Recscue/LG-ultrafine-5k-sun-shades/renders/03-spine.png

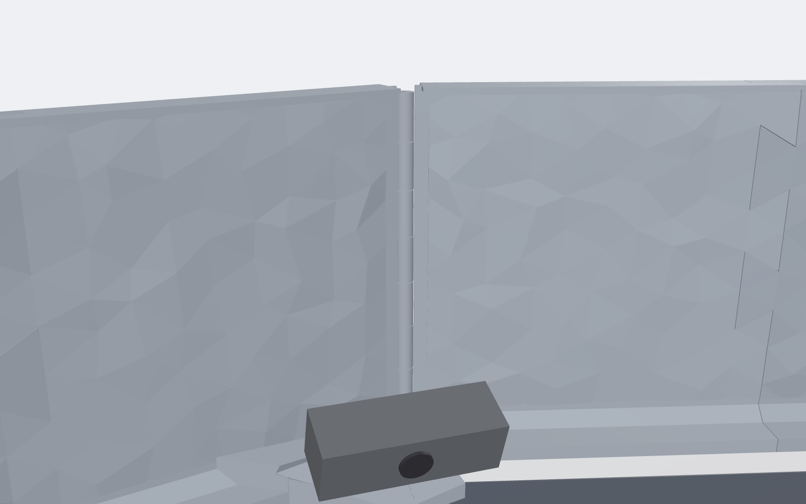
renders/03-spine.png
