Recscue/LG-ultrafine-5k-sun-shades/renders/04-seam-front.png

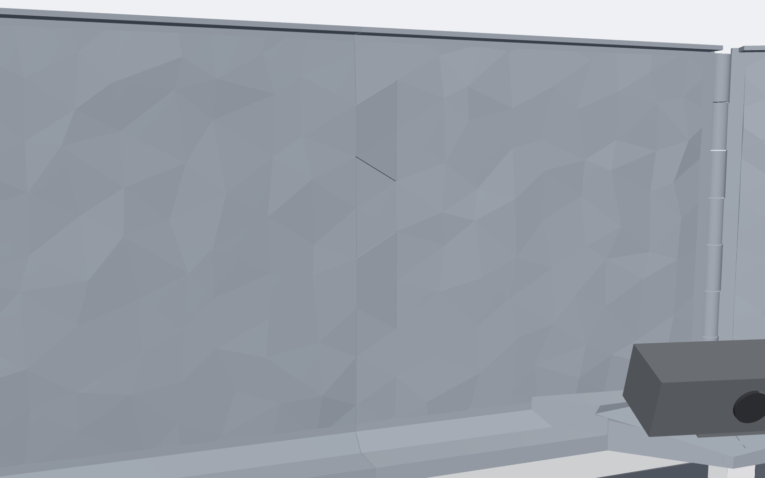
renders/04-seam-front.png
