Recscue/LG-ultrafine-5k-sun-shades/renders/06-exploded.png

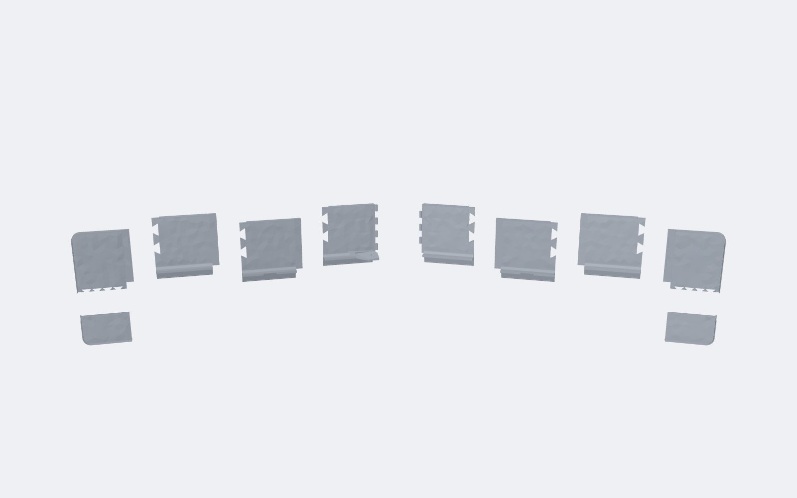
renders/06-exploded.png
