Recscue/LG-ultrafine-5k-sun-shades/renders/08-corner.png

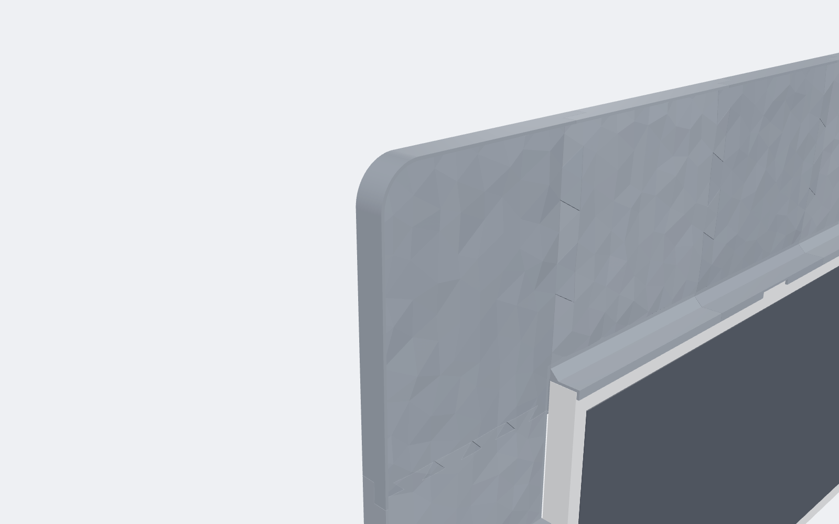
renders/08-corner.png
