Recscue/LG-ultrafine-5k-sun-shades/renders/12-shelf-underside.png

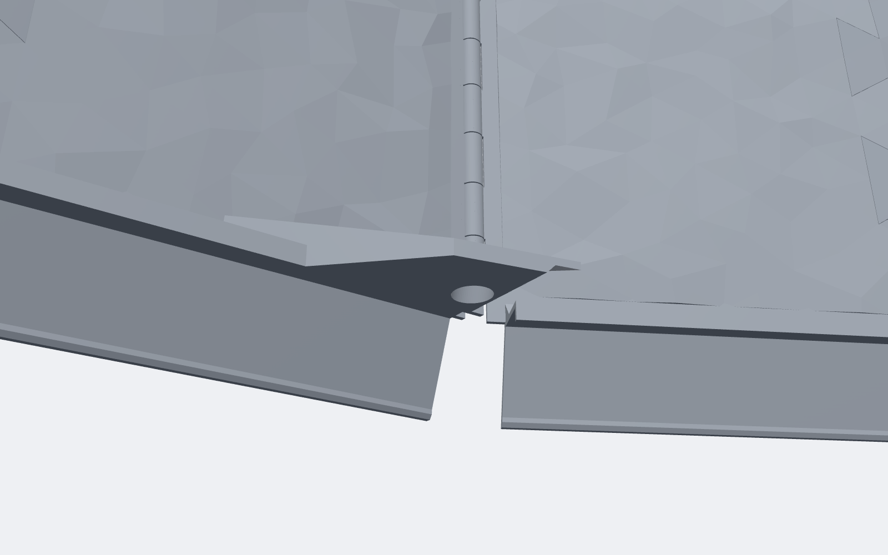
renders/12-shelf-underside.png
