Recscue/LG-ultrafine-5k-sun-shades/renders/13-side-back.png

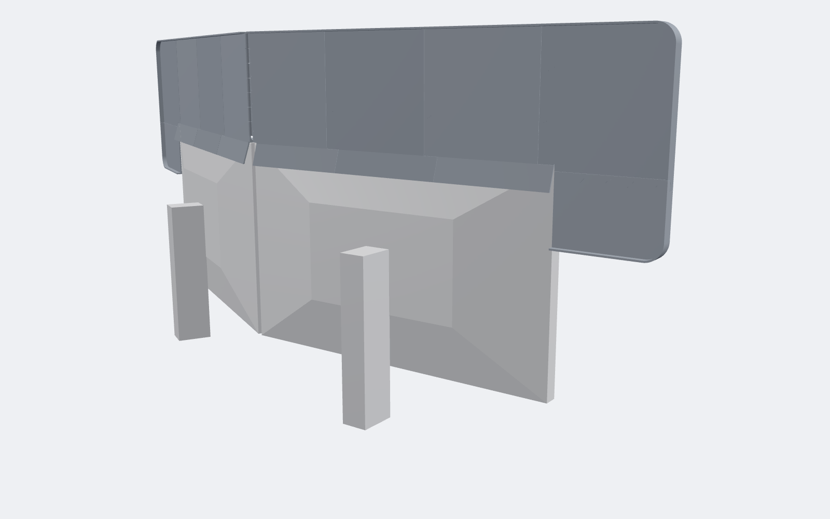
renders/13-side-back.png
