Recscue/LG-ultrafine-5k-sun-shades/renders/14-plateA.png

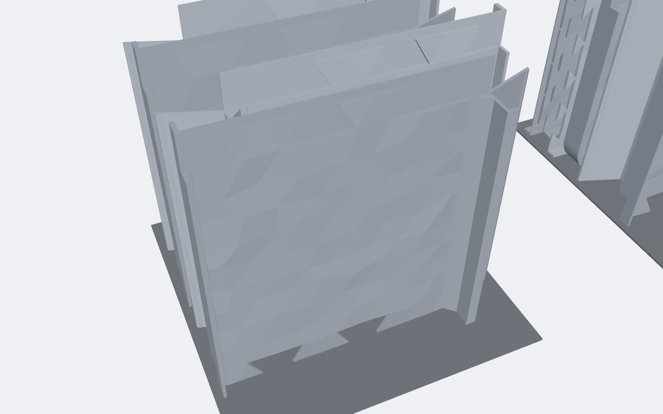
renders/14-plateA.png
