Recscue/LG-ultrafine-5k-sun-shades/renders/14-plateB.png

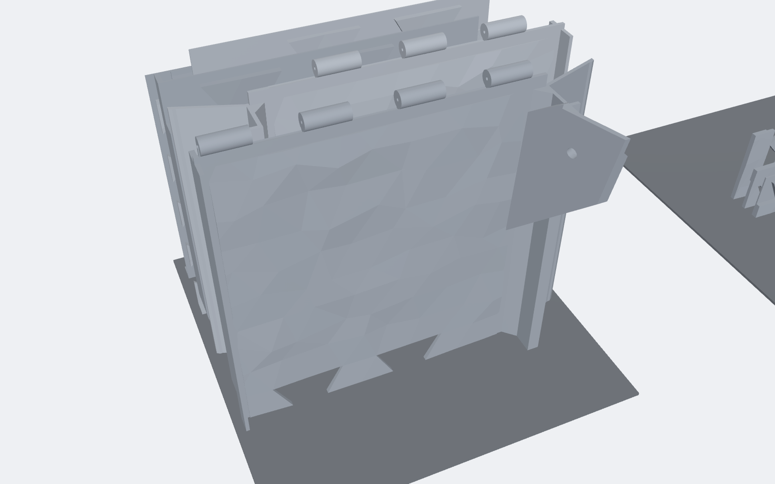
renders/14-plateB.png
