Recscue/LG-ultrafine-5k-sun-shades/renders/14-plateT.png

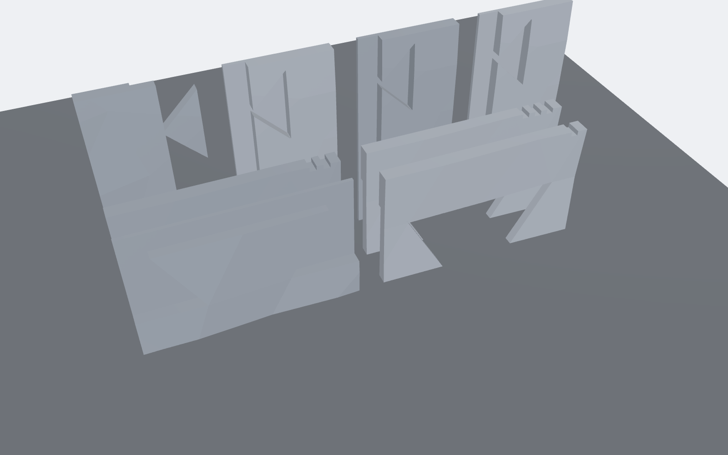
renders/14-plateT.png
