Recscue/LG-ultrafine-5k-sun-shades/print-files/step-1_test-prints/fit_seam_0.10mm_1-notch.stl

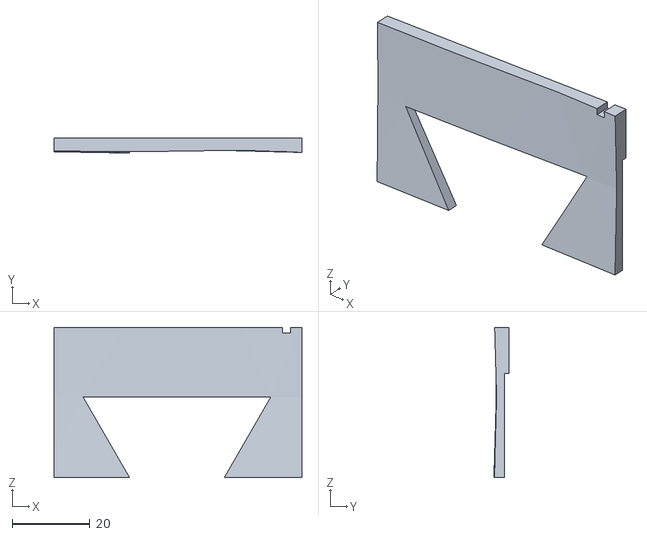
[picture p12: CAD file, 2026-11-04]
print-files/step-1_test-prints/fit_seam_0.10mm_1-notch.stl
64.0 x 3.93 x 38.8
