Recscue/LG-ultrafine-5k-sun-shades/print-files/step-2_full-shield/0.10mm_1-notch/left-monitor/left_4_inner_spine.stl

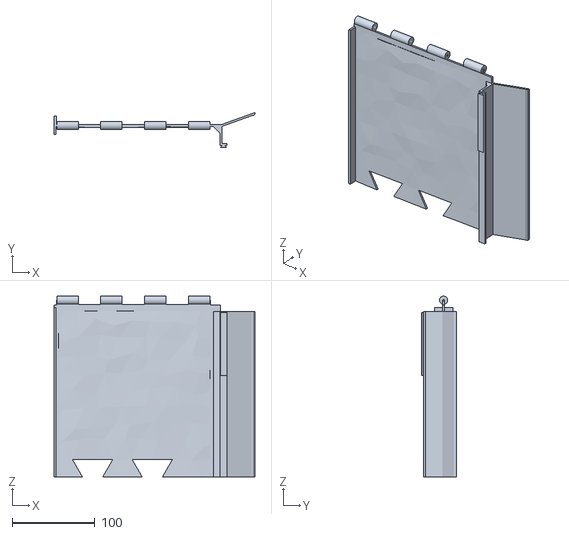
[picture p13: CAD file, 2026-11-04]
print-files/step-2_full-shield/0.10mm_1-notch/left-monitor/left_4_inner_spine.stl
243.2 x 42.3 x 218.8
