Recscue/LG-ultrafine-5k-sun-shades/print-files/step-2_full-shield/0.10mm_1-notch/right-monitor/right_2_outer.stl

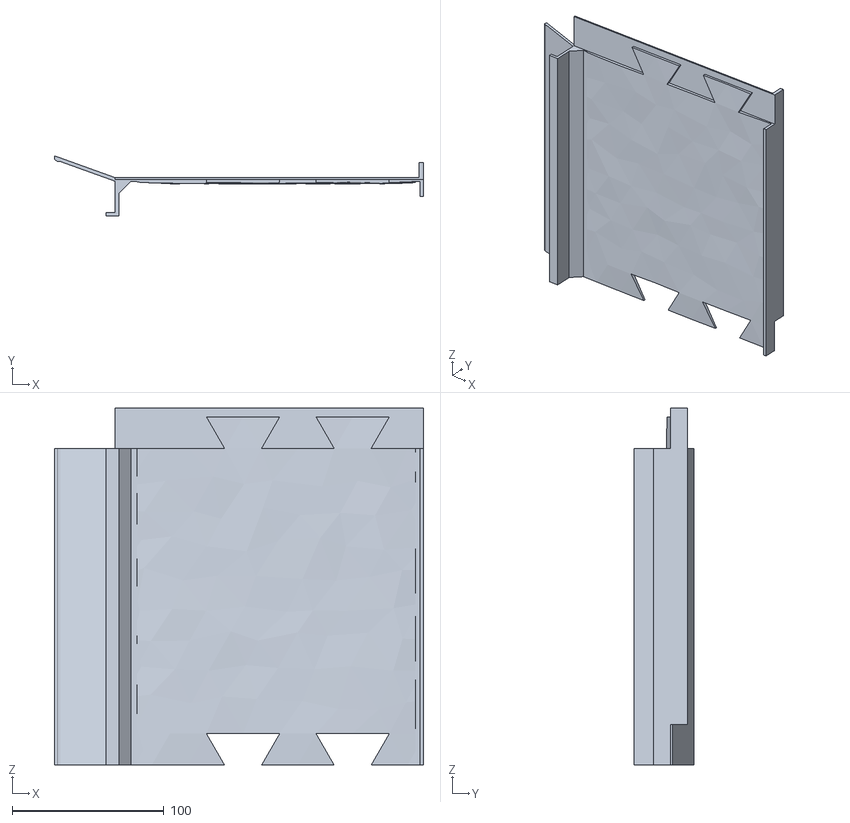
[picture p14: CAD file, 2026-11-04]
print-files/step-2_full-shield/0.10mm_1-notch/right-monitor/right_2_outer.stl
243.2 x 39.8 x 235.3
