Recscue/LG-ultrafine-5k-sun-shades/print-files/step-2_full-shield/0.15mm_2-notch/right-monitor/right_4_inner_spine.stl

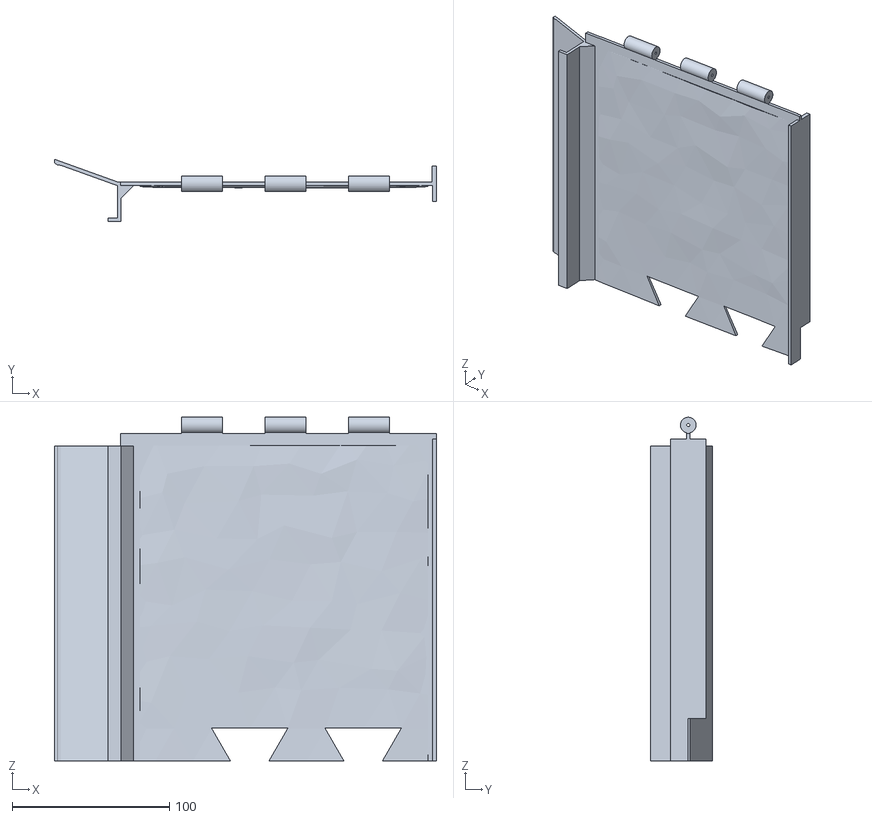
[picture p15: CAD file, 2026-11-04]
print-files/step-2_full-shield/0.15mm_2-notch/right-monitor/right_4_inner_spine.stl
243.2 x 39.8 x 218.7
