Recscue/LG-ultrafine-5k-sun-shades/print-files/step-2_full-shield/0.20mm_3-notch/left-monitor/left_2_outer.stl

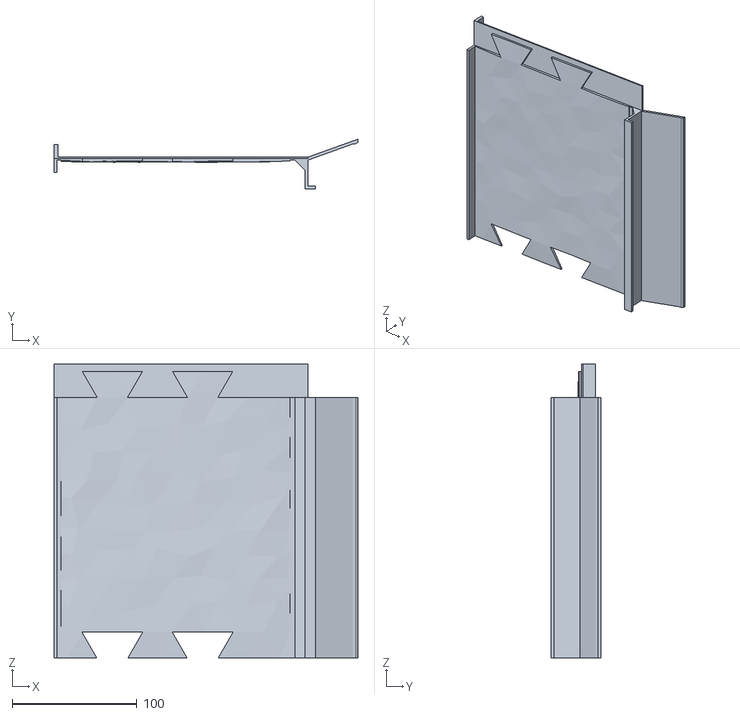
[picture p16: CAD file, 2026-11-04]
print-files/step-2_full-shield/0.20mm_3-notch/left-monitor/left_2_outer.stl
243.2 x 39.8 x 235.2
