Recscue/LG-ultrafine-5k-sun-shades/print-files/step-2_full-shield/0.20mm_3-notch/left-monitor/left_1_side-extension.stl

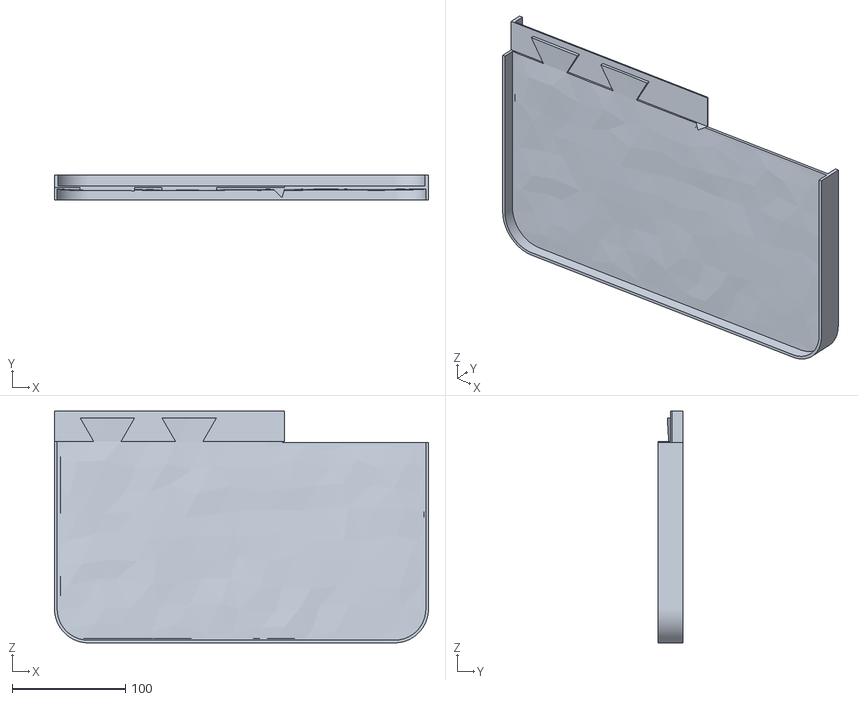
[picture p17: CAD file, 2026-11-04]
print-files/step-2_full-shield/0.20mm_3-notch/left-monitor/left_1_side-extension.stl
330.2 x 22.4 x 204.7
