Recscue/LG-ultrafine-5k-sun-shades/print-files/step-1_test-prints/fixed_seam.stl

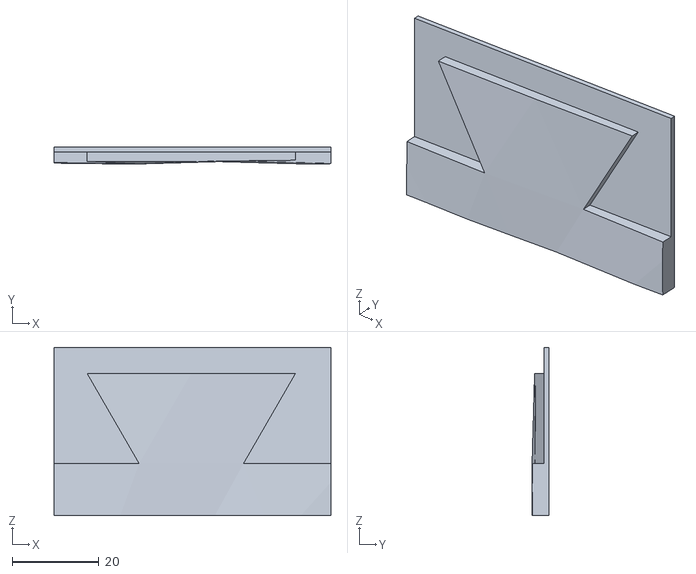
[picture p18: CAD file, 2026-11-04]
print-files/step-1_test-prints/fixed_seam.stl
64.0 x 3.96 x 38.9
