Recscue/LG-ultrafine-5k-sun-shades/print-files/step-2_full-shield/0.10mm_1-notch/left-monitor/left_5_webcam-shelf.stl

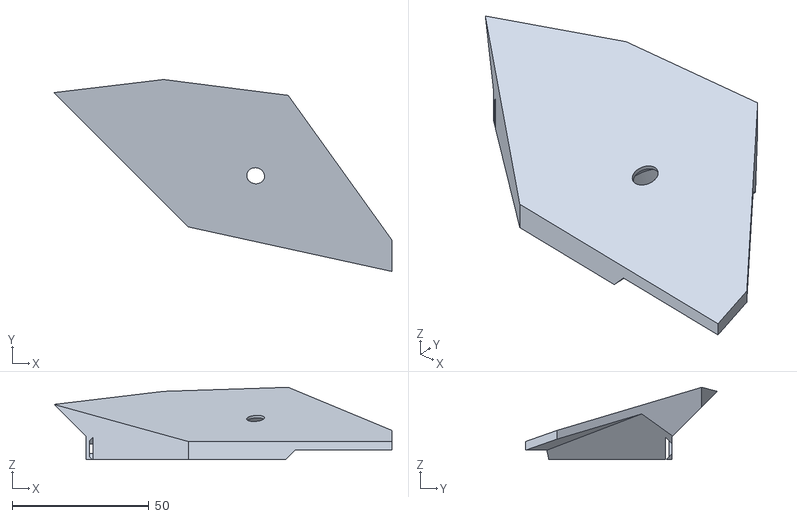
[picture p19: CAD file, 2026-11-04]
print-files/step-2_full-shield/0.10mm_1-notch/left-monitor/left_5_webcam-shelf.stl
123.7 x 70.2 x 26.5
