Recscue/LG-ultrafine-5k-sun-shades/(list of files, cad)

Other CAD files:
print-files/step-2_full-shield/0.15mm_2-notch/left-monitor/left_4_inner_spine.stl
print-files/step-2_full-shield/0.20mm_3-notch/right-monitor/right_2_outer.stl
print-files/step-1_test-prints/fit_seam_0.20mm_3-notch.stl
print-files/step-2_full-shield/0.10mm_1-notch/left-monitor/left_3_middle_monitor-camera-notch.stl
print-files/step-2_full-shield/0.10mm_1-notch/right-monitor/right_3_middle_monitor-camera-notch.stl
print-files/step-2_full-shield/0.15mm_2-notch/left-monitor/left_3_middle_monitor-camera-notch.stl
print-files/step-2_full-shield/0.15mm_2-notch/right-monitor/right_2_outer.stl
print-files/step-2_full-shield/0.20mm_3-notch/right-monitor/right_1_side-extension.stl
print-files/step-2_full-shield/0.10mm_1-notch/left-monitor/left_2_outer.stl
print-files/step-2_full-shield/0.10mm_1-notch/right-monitor/right_1_side-extension.stl
print-files/step-2_full-shield/0.15mm_2-notch/left-monitor/left_1_side-extension.stl
print-files/step-2_full-shield/0.15mm_2-notch/right-monitor/right_1_side-extension.stl
print-files/step-2_full-shield/0.20mm_3-notch/left-monitor/left_3_middle_monitor-camera-notch.stl
print-files/step-2_full-shield/0.20mm_3-notch/right-monitor/right_3_middle_monitor-camera-notch.stl
print-files/step-1_test-prints/fit_seam_0.15mm_2-notch.stl
print-files/step-2_full-shield/0.10mm_1-notch/left-monitor/left_1_side-extension.stl
print-files/step-2_full-shield/0.10mm_1-notch/right-monitor/right_4_inner_spine.stl
print-files/step-2_full-shield/0.15mm_2-notch/left-monitor/left_2_outer.stl
print-files/step-2_full-shield/0.15mm_2-notch/right-monitor/right_3_middle_monitor-camera-notch.stl
print-files/step-2_full-shield/0.20mm_3-notch/left-monitor/left_4_inner_spine.stl
print-files/step-2_full-shield/0.20mm_3-notch/right-monitor/right_4_inner_spine.stl
print-files/step-2_full-shield/0.15mm_2-notch/left-monitor/left_5_webcam-shelf.stl
print-files/step-2_full-shield/0.20mm_3-notch/left-monitor/left_5_webcam-shelf.stl
