Recscue/LG-ultrafine-5k-sun-shades/renders/print-plateB.png

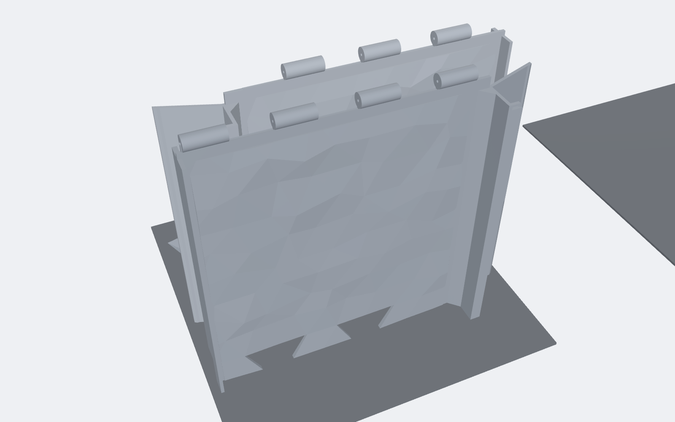
renders/print-plateB.png
