Recscue/LG-ultrafine-5k-sun-shades/renders/print-plateC.png

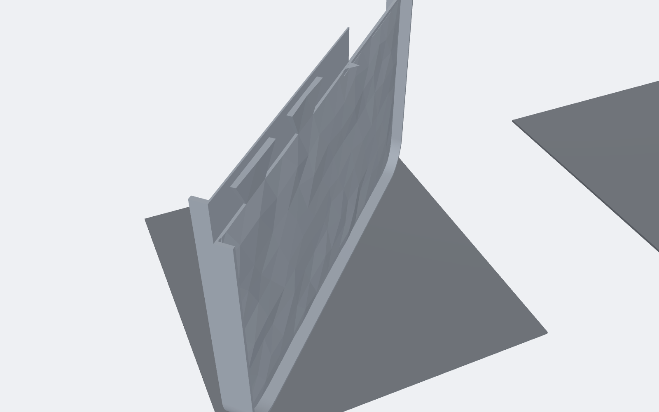
renders/print-plateC.png
