Recscue/LG-ultrafine-5k-sun-shades/renders/print-plateT.png

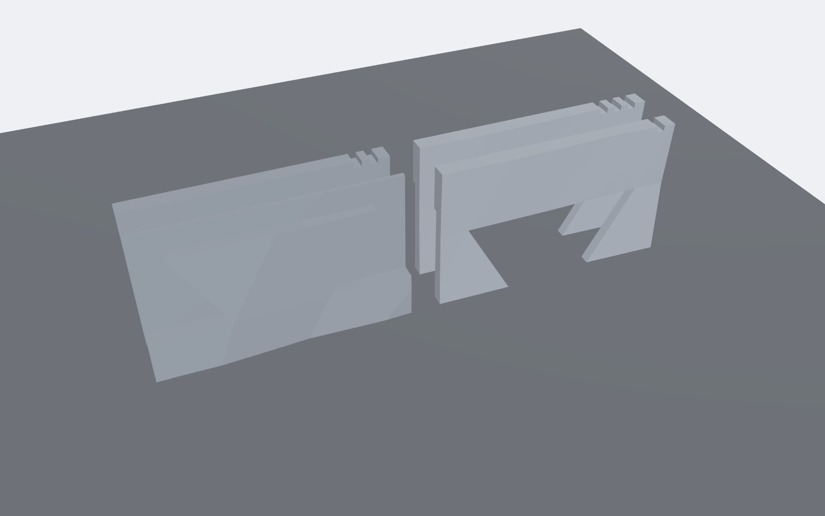
renders/print-plateT.png
