Recscue/LG-ultrafine-5k-sun-shades/(commit log)

2026-11-02 Monitor sun shield: STLs, 3D viewer, parametric model
    [0_fit-test-clip_print-first.stl, left_1_side-extension.stl, left_2_outer.stl, left_3_middle_monitor-camera-notch.stl, left_4_inner_webcam-shelf_spine.stl, right_1_side-extension.stl, right_2_outer.stl, right_3_middle_monitor-camera-notch.stl]
2026-11-02 Round bottom outer corners, wrap rims all round, drop mid rib, match clip to 17 deg monitor back
    [0_fit-test-clip_print-first.stl, left_1_side-extension.stl, left_2_outer.stl, left_3_middle_monitor-camera-notch.stl, left_4_inner_webcam-shelf_spine.stl, right_1_side-extension.stl, right_2_outer.stl, right_3_middle_monitor-camera-notch.stl]
2026-11-02 Fit the measured 152 deg monitor angle; aim the webcam shelf at the center seat
    [left_1_side-extension.stl, left_2_outer.stl, left_3_middle_monitor-camera-notch.stl, left_4_inner_webcam-shelf_spine.stl, right_1_side-extension.stl, right_2_outer.stl, right_3_middle_monitor-camera-notch.stl, right_4_inner_spine.stl]
2026-11-02 Split side extensions on a horizontal dovetail seam to fit the P2S bed; 0.15 mm default fit; joint test coupons
    [coupon_1-notch_horiz-bottom.stl, coupon_1-notch_horiz-top.stl, coupon_1-notch_vert-left.stl, coupon_1-notch_vert-right.stl, coupon_2-notch_horiz-bottom.stl, coupon_2-notch_horiz-top.stl, coupon_2-notch_vert-left.stl, coupon_2-notch_vert-right.stl]
2026-11-04 Full print set at each coupon clearance (0.10, 0.15, 0.20 mm)
    [0_fit-test-clip_print-first.stl, left_1a_side-extension-top.stl, left_1b_side-extension-bottom.stl, left_2_outer.stl, left_3_middle_monitor-camera-notch.stl, left_4_inner_webcam-shelf_spine.stl, right_1a_side-extension-top.stl, right_1b_side-extension-bottom.stl]
2026-11-04 Clearance on one side only so gaps match labels; fixed+fit test pieces; step folders for printing
    [0_fit-test-clip_print-first.stl, coupon_1-notch_horiz-top.stl, coupon_1-notch_vert-left.stl, coupon_1-notch_vert-right.stl, coupon_2-notch_horiz-top.stl, coupon_2-notch_vert-left.stl, coupon_2-notch_vert-right.stl, coupon_3-notch_horiz-top.stl]
2026-11-04 Clip sized from LG drawings; no fit-test clip needed
    [fit-test-clip.stl]
2026-11-04 Clip rebuilt for measured 20 mm top edge (19.8 deg back slope)
    [fit_horizontal-seam_0.10mm_1-notch.stl, fit_horizontal-seam_0.15mm_2-notch.stl, fit_horizontal-seam_0.20mm_3-notch.stl, fixed_horizontal-seam.stl, fixed_vertical-seam.stl, left_1a_side-extension-top.stl, left_1b_side-extension-bottom.stl, left_2_outer.stl]
2026-11-04 Print standing: two plates for the shield, one for the test pieces
2026-11-04 Webcam shelf rebuilt as one solid wedge: single top plane, front edge square to the aim, enclosed screw pocket
    [left_1a_side-extension-top.stl, left_2_outer.stl, left_3_middle_monitor-camera-notch.stl, left_4_inner_webcam-shelf_spine.stl]
2026-11-04 Viewer: Plate A, Plate B and Test plate views of the print layouts
2026-11-04 Printable redesign: one-piece side extensions, separate webcam shelf on a dovetail rail, no sideways dovetails, island and overhang checks
    [fit_horizontal-seam_0.10mm_1-notch.stl, fit_horizontal-seam_0.15mm_2-notch.stl, fit_horizontal-seam_0.20mm_3-notch.stl, fit_seam_0.10mm_1-notch.stl, fit_seam_0.15mm_2-notch.stl, fit_seam_0.20mm_3-notch.stl, fixed_horizontal-seam.stl, fixed_seam.stl]
2026-11-04 Facets capped at 2 mm deep (was 3.4): about half the texture plastic
    [fit_seam_0.10mm_1-notch.stl, fit_seam_0.15mm_2-notch.stl, fit_seam_0.20mm_3-notch.stl, fixed_seam.stl, left_1_side-extension.stl, left_2_outer.stl, left_3_middle_monitor-camera-notch.stl, left_4_inner_spine.stl]
